FrozenStorm/TheEyes/hardware/enclosure/img/v_back.jpg

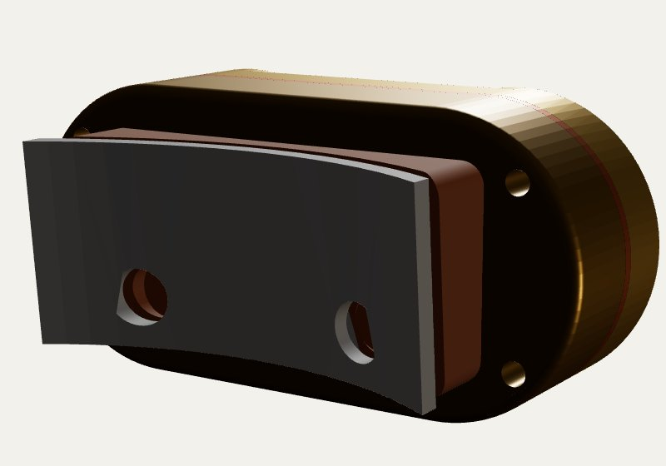
hardware/enclosure/img/v_back.jpg
