FrozenStorm/TheEyes/hardware/enclosure/out/brille_assembly.step

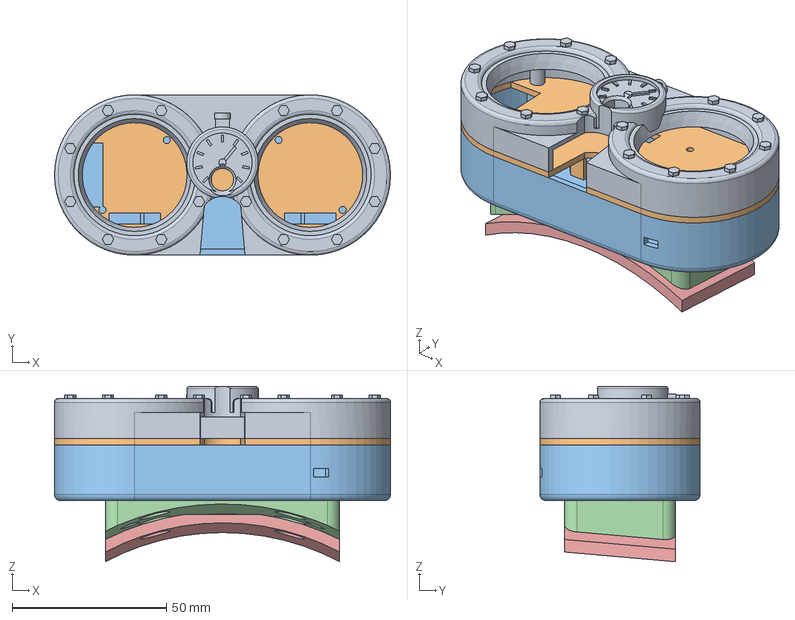
[picture p7: CAD file, 2026-10-24]
hardware/enclosure/out/brille_assembly.step
109.0 x 52.0 x 56.9 mm
front
carrier
back
saddle
counter
