FrozenStorm/TheEyes/hardware/enclosure/out/carrier.step

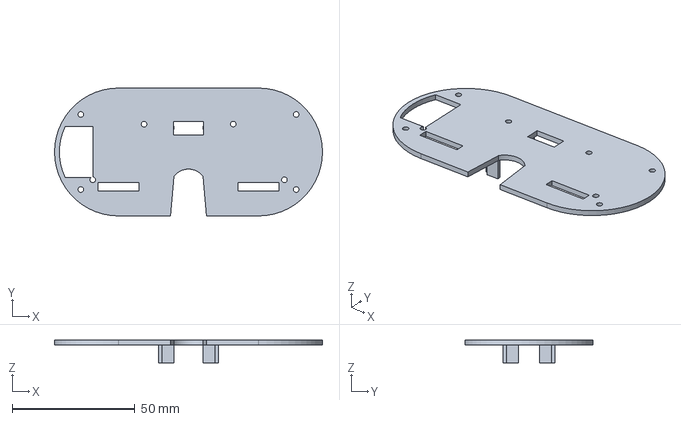
[picture p8: CAD file, 2026-10-24]
hardware/enclosure/out/carrier.step
109.0 x 52.0 x 9.30 mm
