FrozenStorm/TheEyes/hardware/enclosure/out/saddle.step

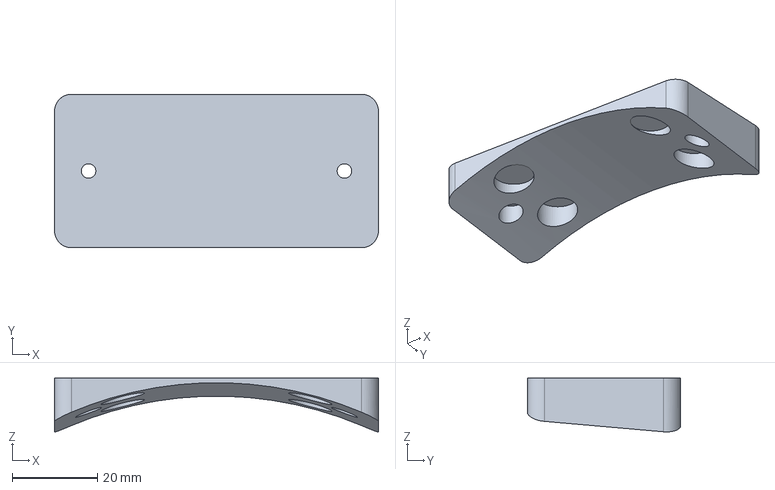
[picture p9: CAD file, 2026-10-24]
hardware/enclosure/out/saddle.step
76.0 x 36.0 x 12.6 mm
