FrozenStorm/TheEyes/hardware/enclosure/out/back.step

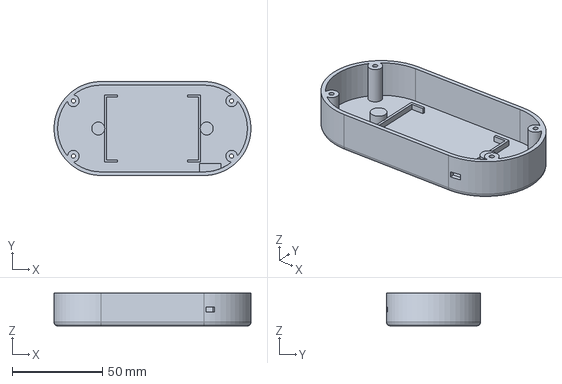
[picture p10: CAD file, 2026-10-24]
hardware/enclosure/out/back.step
109.0 x 52.0 x 18.1 mm
