FrozenStorm/TheEyes/hardware/enclosure/out/counter.step

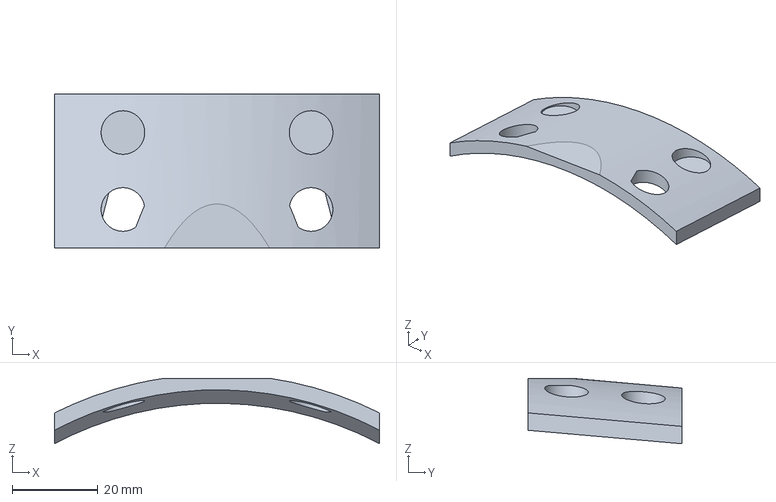
[picture p11: CAD file, 2026-10-24]
hardware/enclosure/out/counter.step
76.0 x 36.0 x 15.3 mm
