FrozenStorm/TheEyes/hardware/enclosure/out/front.step

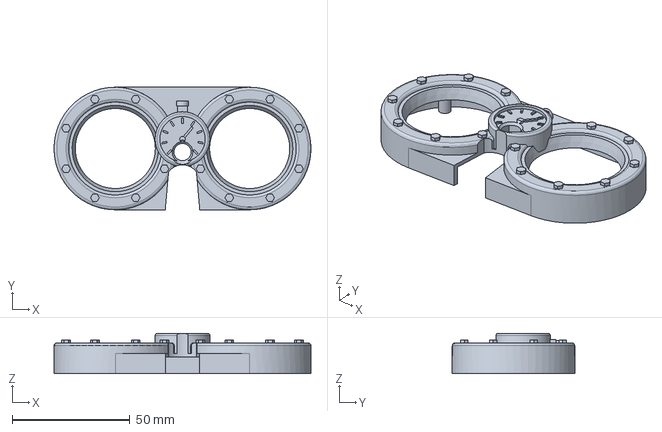
[picture p12: CAD file, 2026-10-24]
hardware/enclosure/out/front.step
109.0 x 52.0 x 17.0 mm
