FrozenStorm/TheEyes/(list of files, cad)

Other CAD files:
hardware/enclosure/out/back.stl
hardware/enclosure/out/carrier.stl
hardware/enclosure/out/counter.stl
hardware/enclosure/out/front.stl
hardware/enclosure/out/saddle.stl
