FrozenStorm/TheEyes/(commit log)

2026-10-06 Initial commit: dual GC9A01 animated eyes, builds on ESP-IDF 6.1
    Waveshare ESP32-S3 dual 1.28" round LCD demo with a simple LVGL
    canvas eye animation. Ported to build with ESP-IDF 6.1:
    - drop unused espressif/esp-dsp (1.4.x fails to compile with GCC 15)
    - use rgb_ele_order / LCD_RGB_ELEMENT_ORDER_BGR (IDF 6 LCD API)
    - #undef LV_USE_FS_FATFS before redefining it in lv_fs_port.c
    Verified running on the board.
    [partitions.csv]
2026-10-06 Add realistic eye renderer with natural eye motion
    New RealEyes module renders both eyes per pixel without LVGL, one task
    per core, streaming 20-line strips to the panels via DMA (~25 fps each):
    - procedural textures generated at boot: polar iris (fibres, collarette,
    crypts, limbal ring), per-eye sclera with veins and spherical shading
    - iris foreshortening on sideways gaze, soft limbus, fixed corneal
    highlight, eyelids with lash line and cast shadow, socket vignette
    - motion model: saccades with fixations and drift, blinks (incl. double
    and saccade-coupled), lid tracking of vertical gaze, pupil hippus
    Selectable in menuconfig ("Realistic Eyes", incl. iris colour); the
    original LVGL a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
    [Eye_Motion.c, Eye_Motion.h, Eye_Textures.c, Eye_Textures.h, RealEyes.c, RealEyes.h, main.c]
2026-10-19 Add Gaze Link: eyes look at people reported by a camera board
    GazeLink receives gaze_msg_t (common/gaze_msg.h) over ESP-NOW and
    Eye_Motion turns it into attention with saccades, pursuit and glances.
    sender/ is a simple face sender for the XIAO ESP32S3 Sense; the full
    tracker lives in the separate HeadTracking repo.
    [partitions.csv]
2026-10-24 Add 3D-printable steampunk goggles enclosure for eyes and camera
    Parametric CadQuery model (hardware/enclosure/brille.py) with STL/STEP
    exports: porthole front with pressure gauge camera window, carrier plate
    for the Waveshare DualEye board and the XIAO, rear cover with LiPo bay
    and switch, and a magnetic hat saddle with counter plate.
    Claude-Session: https://claude.ai/code/session_01TaNQunqcKrRZBqE72zvC6C
    [back.step, back.stl, brille_assembly.step, carrier.step, carrier.stl, counter.step, counter.stl, front.step]
2026-10-24 Set hat crown radius to the measured 87.5 mm
    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
    [brille_assembly.step, counter.step, counter.stl, saddle.step, saddle.stl]
